CircuitChaos/EtchingHeater/README.md

# Etching machine heater controller

See this video for detailed explanation: https://youtu.be/3gxSSFc57wU 

<a href="http://www.youtube.com/watch?feature=player_embedded&v=3gxSSFc57wU" target="_blank">Video</a>
