CircuitChaos/EtchingHeater/doc/video slides.odt

Etching machine
heater controller

This is a simple project made in two evenings, but it's either this or nothing, so I decided to post it anyway.

Many hobbyists nowadays order PCBs from Chinese manufacturers (if you watch certain YouTube channels then you definitely saw these annoying sponsor blocks). It's relatively cheap and convenient, because you don't have to make a mess etching your own PCBs, but it has disadvantages too – most importantly, it takes some time for the manufacturer to make and deliver your PCB from China. It's not very convenient when you have an idea, a free weekend, and want to have it done here and now.

As most of my projects are just like this – a quick project that I want done here and now – I still, in 2023, etch virtually all of my PCBs myself.

That's why I made a new controller for my PCB etching contraption. It's a simple thermostat, really, with an aquarium pump strapped to its case (used to mix the solution), but it has some non-obvious features.

It senses the solution temperature with an LM35 sensor and drives the heater relay to keep it around 50°C. Nothing fancy here, no PID regulation, it's just a hysteresis-based on/off controller. There are cheap, ready-made controllers that do just that.

When temperature reaches 40°C, it emits a message that the solution is warm enough for the PCB to be inserted into it. It doesn't disable the heater yet.

You guessed it right, it's Morse code. It says „READY”. Since I learned Morse code, I make most of my tools communicate with me with it, instead of some random pattern of beeps.

It looks ugly, BTW, because I reused the old case (it's the second iteration, first one was created ~10 years ago).

Heater is disabled when temperature reaches 50°C and reenabled once it falls to 49°C. A small hysteresis, but it's enough (and tests show that it could be made even smaller, but there's no real need to lower it).

If a temperature reading falls out of a reasonable range (15°C – 55°C), the controller enters an error state, disables the heater, blinks the display, and emits a constant error pattern („LOW” or „HIGH”, again in Morse), so I can go and check what happened. I didn't want to reenable the heater if temperature reached a valid range again, because if something's wrong (a connection to the sensor is intermittent, or something), I want to fix it, not to pretend the problem doesn't exist (and boil my solution).

Hardware is very simple. It consists of three boards. One is a 12 V PSU salvaged from some other device. Another is a relay board – it contains the relay, its transistor, and a 7805 voltage regulator. Third board is the controller itself. It contains an ATmega8A MCU, a display, a voltage reference (TL431), and a buzzer.

Software might seem overcomplicated, but I had plenty of flash space (8 kB, I used around 26% of it) and I wanted to make sure that measurements are as accurate as possible.

CPU is clocked with at internal 8 MHz RC oscillator. There's a timer (TIMER2) that fires an overflow interrupt at around 488 Hz (CPU clock is prescaled by 64 and timer is counting to 256 before overflowing). Overflow ISR handles the display refresh (display is multiplexed), blinking, and buzzer (emitting Morse codes).

After everything is initialized, program enters its main loop. In it, it resets the watchdog timer and enters idle sleep mode, waiting for the timer overflow event.

Once timer overflow event fires and display and buzzer are refreshed, the program has 2048 µs (minus time needed to handle timer's ISR) for other activities. One of these activities is reading the ADC.

ADC clock runs at 62.5 kHz (CPU clock prescaled by 128). It takes 25 cycles, or 400 µs, for the ADC to complete a measurement. It's because ADC is enabled only for the conversion (otherwise entering the idle sleep mode would trigger it). To lower the noise, conversion is done in the ADC noise reduction sleep mode – everything is halted except the ADC and asynchronous timer (TIMER2). That's why TIMER2 was chosen. It won't overflow mid-conversion, because ADC starts only after the CPU is woken up from the idle sleep by the timer's overflow ISR.

Once the ADC conversion is done, a read value is sent to the filtering module, which performs 256 oversampling cycles before actually using the (oversampled) value. After oversampling (so at around 1.9 Hz, or almost two times per second), an oversampled value is sent to the moving average array, consisting of 16 slots. If array is not full (on boot), values are added to it. When it's finally full, it's shifted to make room for a new value and used to calculate the average ADC reading. This reading, after oversampling, will be huge, so after averaging it's normalized to 0 … 65472 (1023 × 1024) range.

The oversampling factor is quite high, but it has been chosen mostly to keep the correct display refresh rate.

One point to note is that after heater's relay changes its state, eight consecutive ADC readings are discarded. This is to further filter any ripples that might appear on the sensitive analog line.

Anyway, after filter decides that it has done all its oversampling and calculated the moving average ADC value, this value is converted to temperature using a simple formula: temp = Uref × value ÷ 65536, where Uref is the voltage on the VREF pin measured after assembling everything (2472 mV).

LM35's output scale factor is 10 mV / °C, so after this calculation the temperature will be in units of °C/10 (so, for example, 20.5°C will be represented as 205). This fixed-point approach is convenient and all other temperature comparisons use these units too.

Next, error condition is inspected (and possibly set, together with the blinking mode and beeper) and if there's no error, then heater hysteresis and solution readiness (40°C) detection is done.

After that, temperature value is converted to a 7-segment display format, a dot representing enabled heater output is added at the end (after the third digit), and values for individual segments are sent to the display module to be updated in the timer's ISR after it finishes multiplexing the current set of values.

If the temperature reading exceeds 99.9°C, a display just displays „1” on the first position. I wasted no time adding code to handle temperatures above 99.9°C, because it's an error condition anyway.

Even in such simple (especially from the hardware point of view) project, and even after using AVR microcontrollers in my projects for almost 20 years, I still made a mistake. I wanted to use the full ADC range, at least on the upper side, so I initially added a voltage divider to provide the voltage reference of 800 mV. It turned out that it's below specs for ATmega8A (and it's, of course, mentioned in the electrical characteristics section of the datasheet) and the result was a consistent reading of 0x3ff (1023, maximum ADC value), even when I switched the ADC multiplexer to sample ground value.

We always learn…

Project files (.sch in Eagle format, .pcb in AutoTrax format) and firmware has been posted on GitHub:

https://github.com/CircuitChaos/EtchingHeater

Links is also in the description.

Thanks for watching!
