CircuitChaos/EtchingHeater/doc/pcb1.png

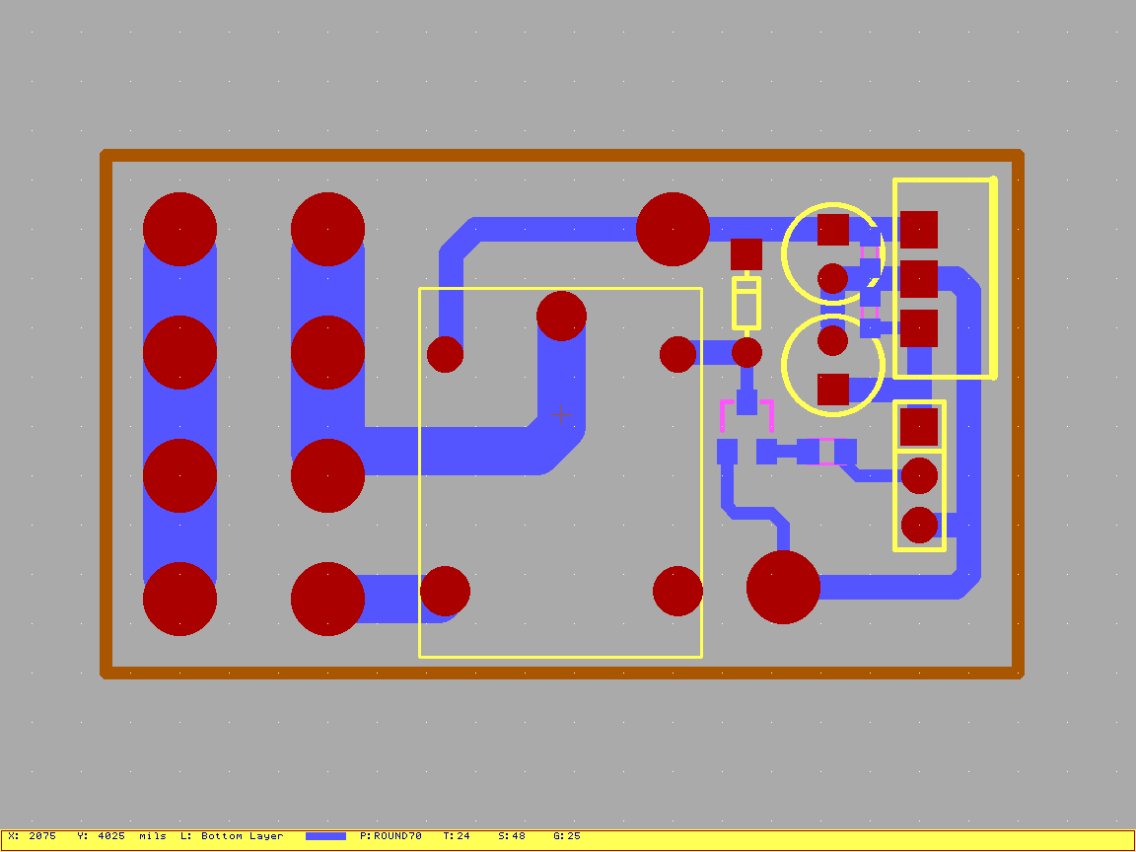
doc/pcb1.png
