CircuitChaos/EtchingHeater/doc/pcb2.png

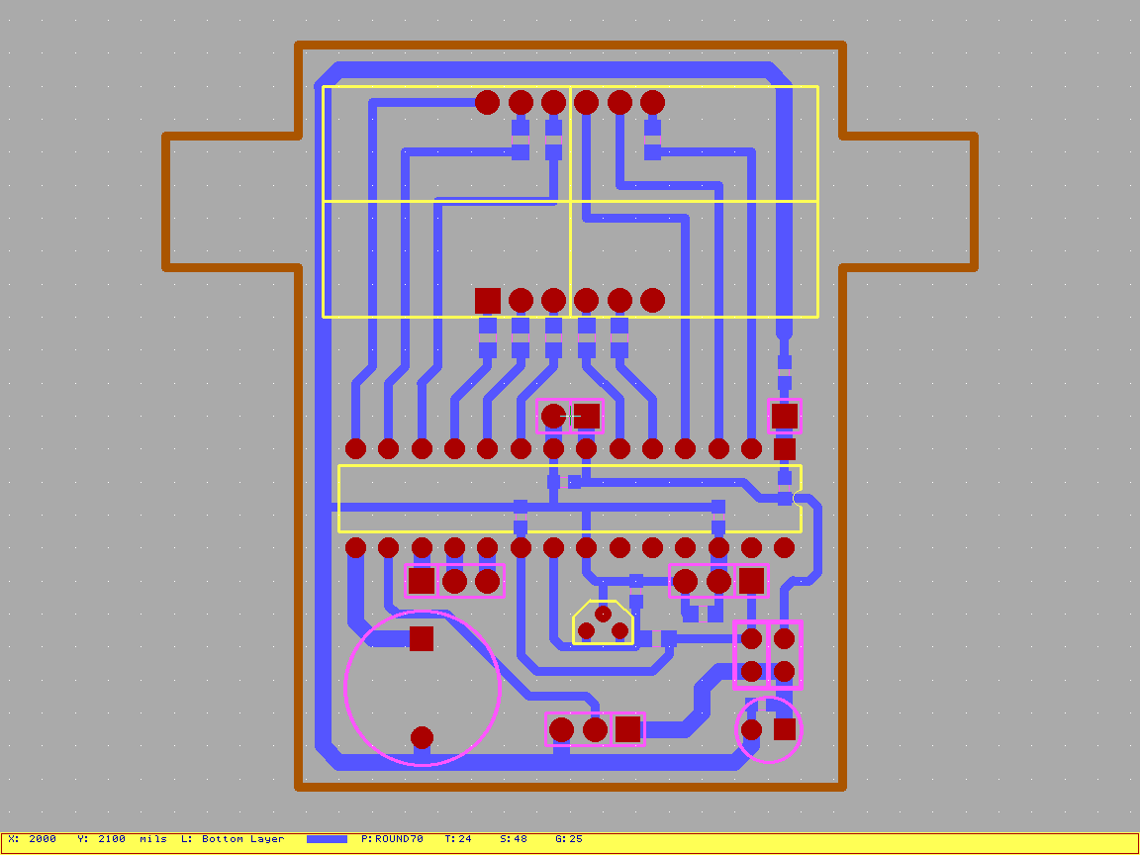
doc/pcb2.png
