CircuitChaos/EtchingHeater/doc/sch.png

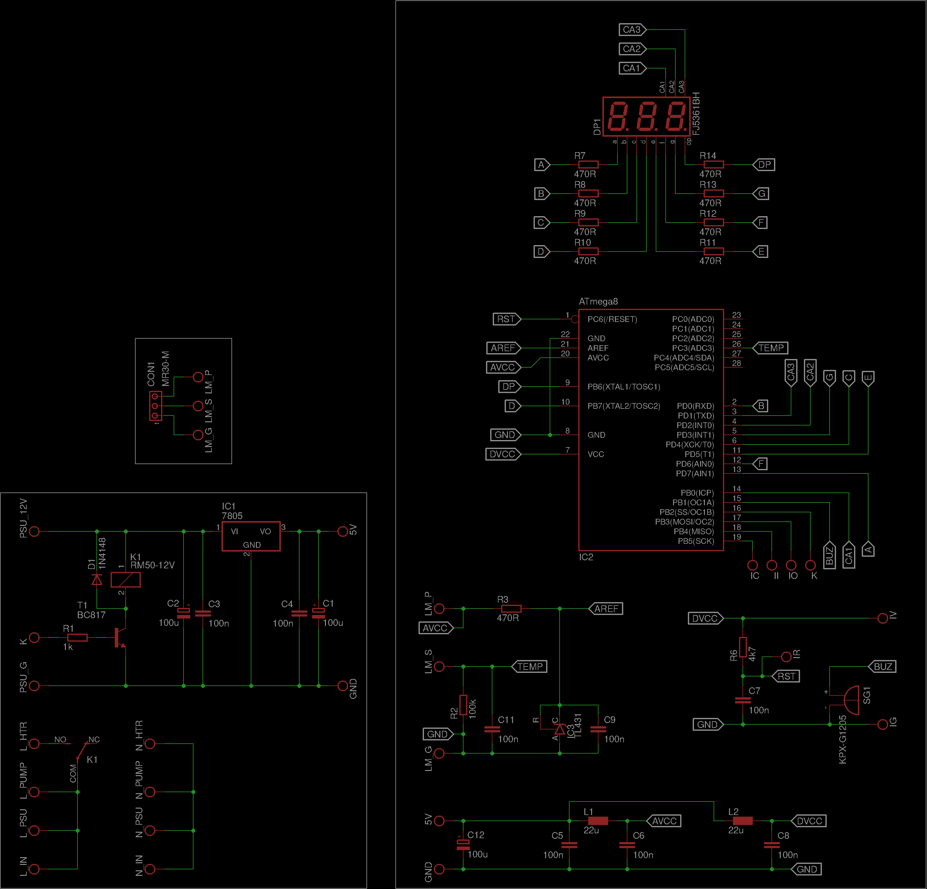
doc/sch.png
