CircuitChaos/EtchingHeater/(list of files, drawings)

Other design files:
doc/etchctrl.pcb
