CircuitChaos/EtchingHeater/doc/etchctrl.sch

## EAGLE design doc/etchctrl.sch (2023-11-17)

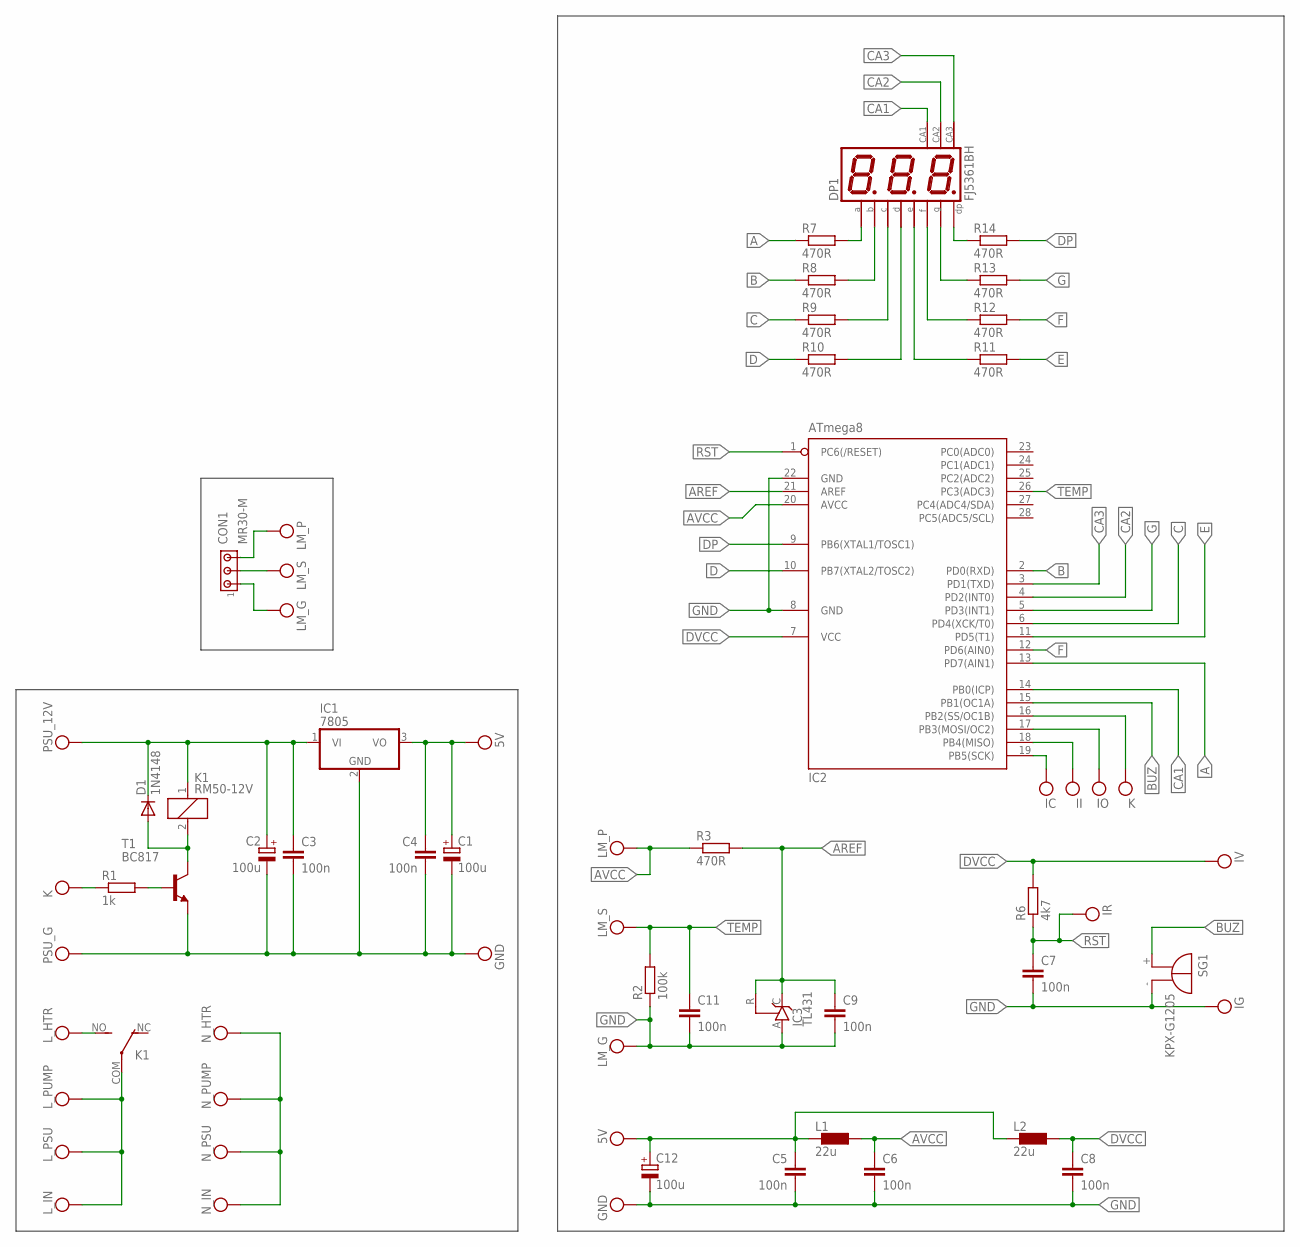
[picture p4: schematic etchctrl.sch]

Parts:
C1, C2, C12: 100u; 085CS_1AR
C3, C4, C5, C6, C7, C8, C9, C11: 100n; C2.5-3
CON1: MR30-M; 10X03MTA
D1: 1N4148; DO35-7
DP1: FJ5361BH; BX56-12
IC1: 7805; TO220V
IC2: ATmega8; DIL28-3
IC3: TL431; TO92-CLP
K1: RM50-12V; APF30212C
L1, L2: 22u; L1812
R1: 1k; R0805
R2: 100k; R0805
R3, R7, R8, R9, R10, R11, R12, R13, R14: 470R; R0805
R6: 4k7; R0805
SG1: KPX-G1205; F/EB20P
T1: BC817; SOT23-EBC

Connections:
A: IC2.13 (PD7(AIN1)), R7.1
AREF: C9.1, IC2.21 (AREF), IC3.C, IC3.R, R3.2
AVCC: C6.1, IC2.20 (AVCC), L1.1, R3.1
B: IC2.2 (PD0(RXD)), R8.1
BUZ: IC2.15 (PB1(OC1A)), SG1.+
C: IC2.6 (PD4(XCK/T0)), R9.1
CA1: DP1.12 (CA), IC2.14 (PB0(ICP))
CA2: DP1.9 (CA), IC2.4 (PD2(INT0))
CA3: DP1.8 (CA), IC2.3 (PD1(TXD))
D: IC2.10 (PB7(XTAL2/TOSC2)), R10.1
DP: IC2.9 (PB6(XTAL1/TOSC1)), R14.2
DVCC: C8.1, IC2.7 (VCC), L2.1, R6.2
E: IC2.11 (PD5(T1)), R11.2
F: IC2.12 (PD6(AIN0)), R12.2
G: IC2.5 (PD3(INT1)), R13.2
GND: C5.2, C6.2, C7.2, C8.2, C9.2, C11.2, C12.-, IC2.8 (GND), IC2.22 (GND), IC3.A, R2.1, SG1.-
unnamed: D1.A, K1.2, T1.C
unnamed: R1.2, T1.B
unnamed: DP1.11 (A), R7.2
unnamed: DP1.7 (B), R8.2
unnamed: DP1.4 (C), R9.2
unnamed: DP1.2 (D), R10.2
unnamed: DP1.1 (E), R11.1
unnamed: DP1.10 (F), R12.1
unnamed: DP1.3 (DP), R14.1
unnamed: DP1.5 (G), R13.1
RST: C7.1, IC2.1 (PC6(/RESET)), R6.1
TEMP: C11.1, IC2.26 (PC3(ADC3)), R2.2
VCC: C1.+, C1.-, C2.+, C2.-, C3.1, C3.2, C4.1, C4.2, C5.1, C12.+, CON1.1, CON1.2, CON1.3, D1.C, IC1.1 (VI), IC1.2 (GND), IC1.3 (VO), IC2.16 (PB2(SS/OC1B)), IC2.17 (PB3(MOSI/OC2)), IC2.18 (PB4(MISO)), IC2.19 (PB5(SCK)), K1.1, K1.COM, K1.NO (S), L1.2, L2.2, R1.1, T1.E
